treyfortmuller/ee192/README.md

# EE192 Spring 2018: Team 6
Joey Kroeger, Trey Fortmuller, Charlene Shong

### Development Workflow
* The master branch should always be functional.
* For each checkoff, create a branch. When the branch is working and tested, merge it into master.
