treyfortmuller/ee192/notes_and_reference/project_proposal/Proposal Tips.txt

Project Proposal Tips from Varun

Tips from Varun (Discussion):

Essentials
- camera
- chasis/wheels
- motor(s)
- servo 
- e-stop
- battery/power system
- front bumper
Nice to Have
- 2nd camera
- speed sensor
- telemetry/(bluetooth chip)
Sensors
- camera 
- speed (encoder)
- accelerometer
Planning
- which direction? (vision mapper)
- what speed?
