treyfortmuller/ee192/datasheets/optical_encoder_tcrt1000/EasyPulseCircuit.png

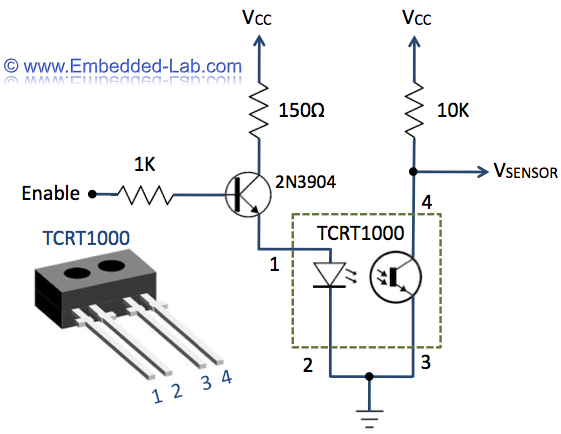
datasheets/optical_encoder_tcrt1000/EasyPulseCircuit.png
