treyfortmuller/ee192/hw2/CarSim2018/2018/successful_runs/1_2.png

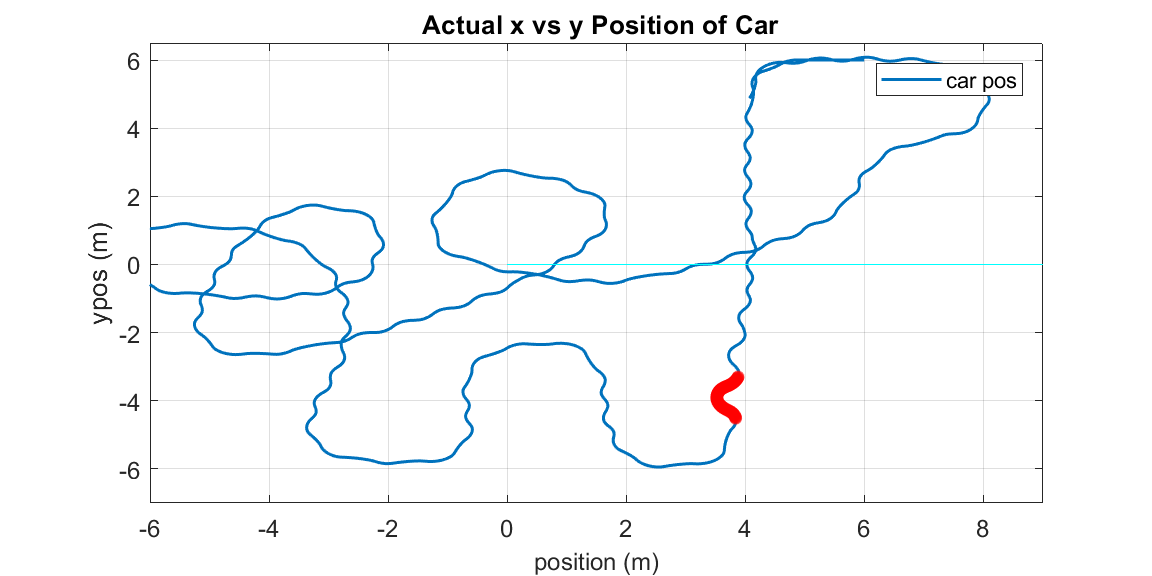
hw2/CarSim2018/2018/successful_runs/1_2.png
