treyfortmuller/ee192/hw2/CarSim2018/2018/successful_runs/2_1.png

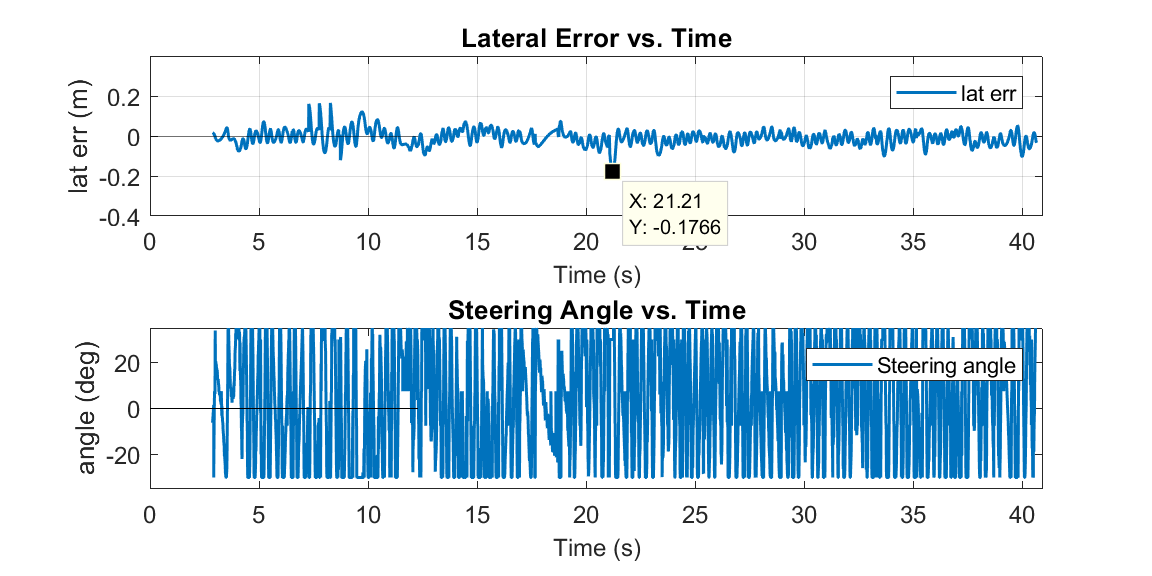
hw2/CarSim2018/2018/successful_runs/2_1.png
