treyfortmuller/ee192/hw2/CarSim2018/2018/successful_runs/2_12.png

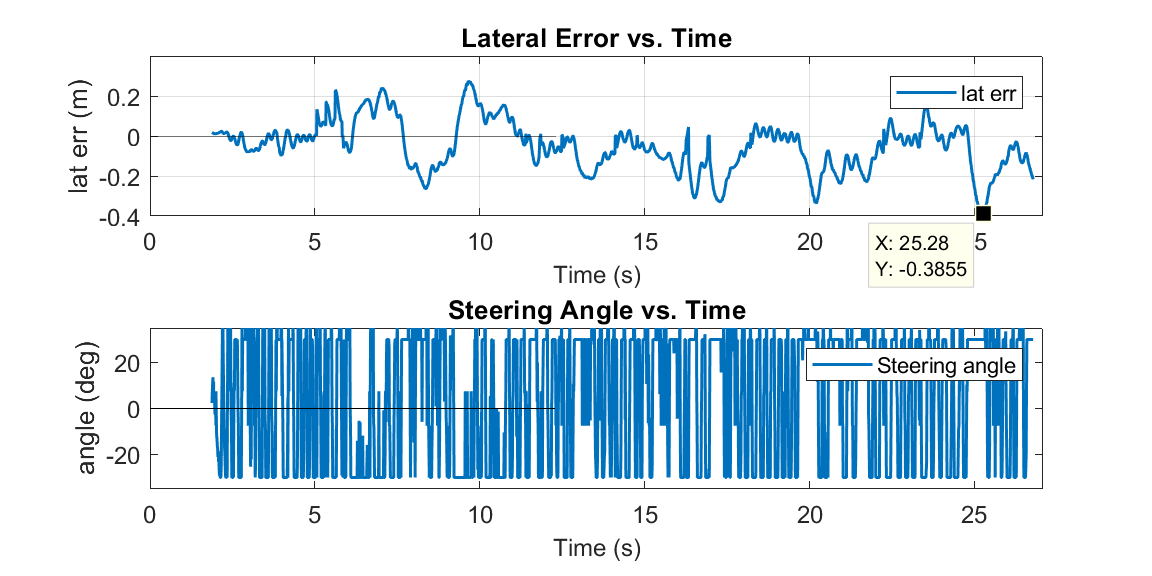
hw2/CarSim2018/2018/successful_runs/2_12.png
