treyfortmuller/ee192/hw2/CarSim2018/2018/successful_runs/4_2.png

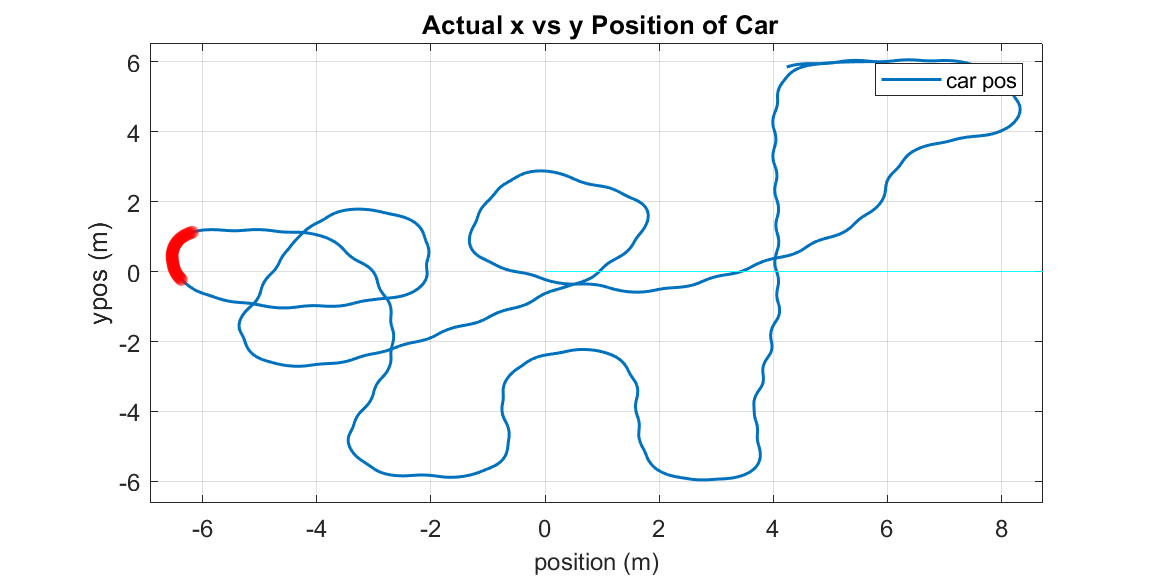
hw2/CarSim2018/2018/successful_runs/4_2.png
