treyfortmuller/ee192/motor_drive_pcb/PCBv1.PNG

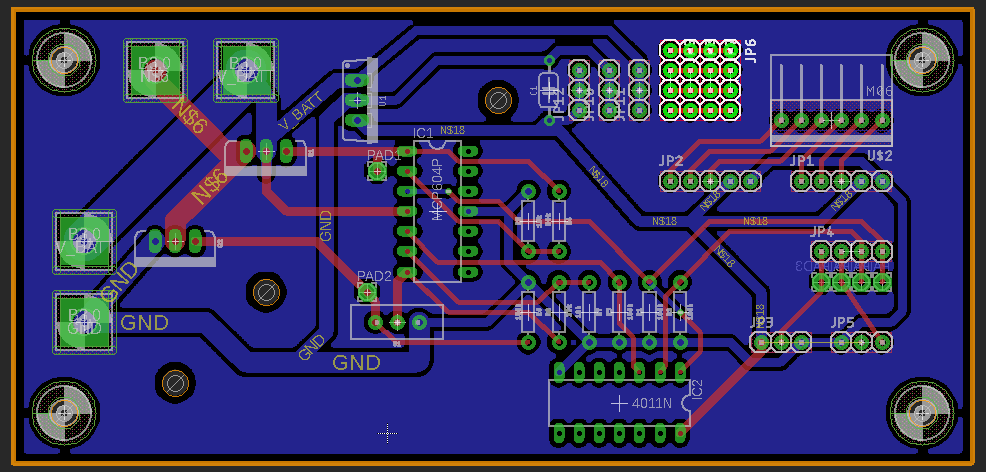
motor_drive_pcb/PCBv1.PNG
