treyfortmuller/ee192/notes_and_reference/project_proposal/motor_circuit.png

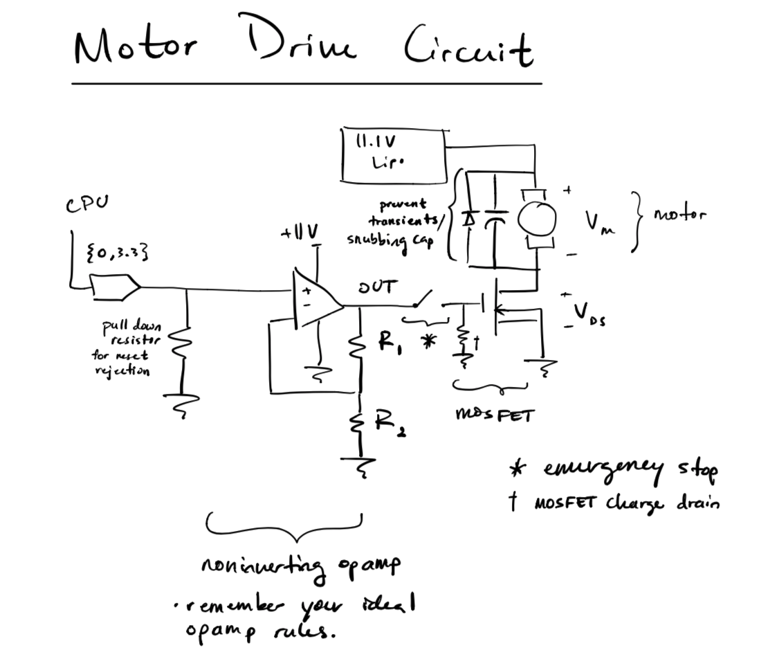
notes_and_reference/project_proposal/motor_circuit.png
