treyfortmuller/ee192/notes_and_reference/sakura_d4_chassis_CAD/SakuraD4Chassis.step

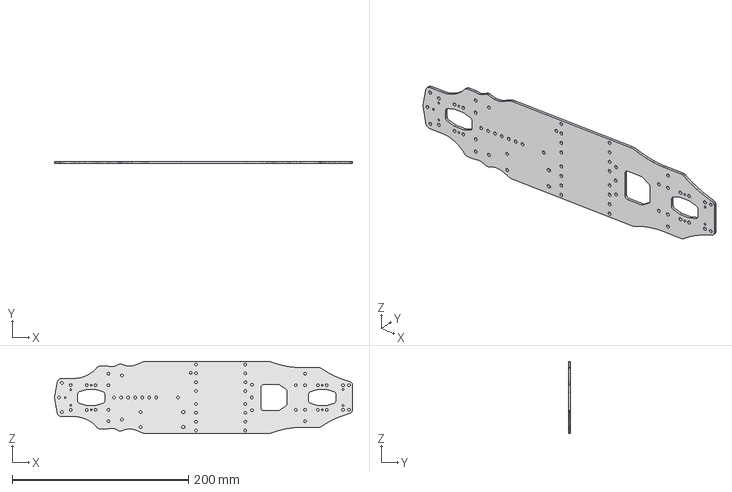
[picture p31: CAD file, 2018-02-09]
notes_and_reference/sakura_d4_chassis_CAD/SakuraD4Chassis.step
338.1 x 2.50 x 82.0 mm
