treyfortmuller/ee192/(list of files, cad)

Other CAD files:
notes_and_reference/sakura_d4_chassis_CAD/SakuraD4Chassis.dwg
notes_and_reference/sakura_d4_chassis_CAD/SakuraD4Chassis.dxf
