treyfortmuller/ee192/motor_drive_pcb/k64_breakout.brd

## EAGLE design motor_drive_pcb/k64_breakout.brd (2018-04-05)

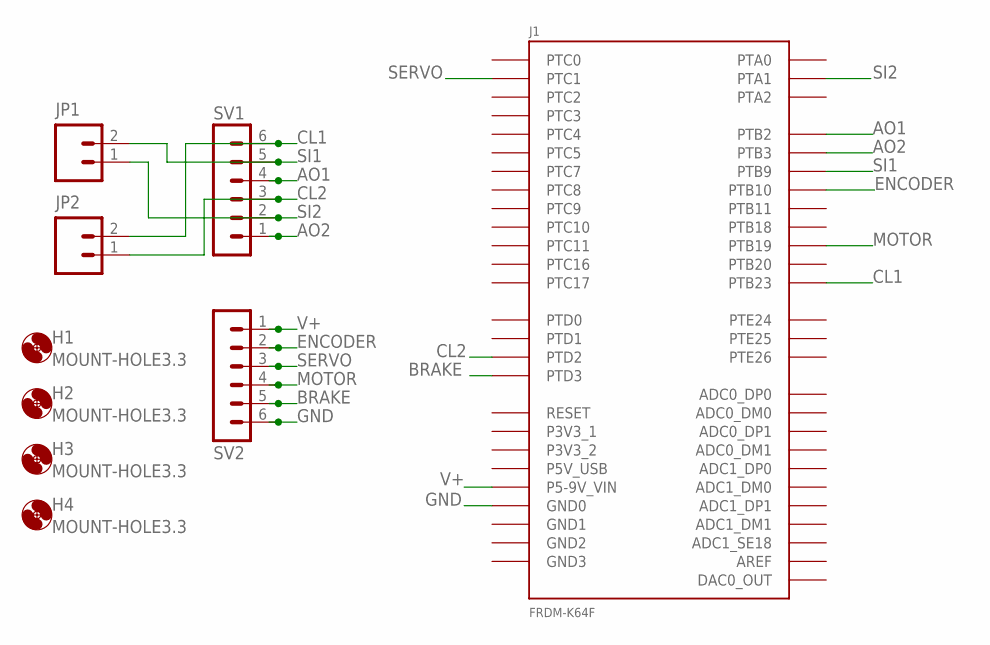
[picture p36: schematic k64_breakout.sch]

Parts:
H1, H2, H3, H4: MOUNT-HOLE3.3; 3,3
J1: FRDM-K64F
JP1, JP2: M02PTH; 1X02
SV1, SV2: MA06-1

Connections:
AO1: J1.J4-2 (PTB2), SV1.4
AO2: J1.J4-4 (PTB3), SV1.1
BRAKE: J1.J2-10 (PTD3), SV2.5
CL1: J1.J1-10 (PTB23), JP2.2, SV1.6
CL2: J1.J2-8 (PTD2), JP2.1, SV1.3
ENCODER: J1.J4-6 (PTB10), SV2.2
GND: J1.J2-3 (GND0), SV2.6
MOTOR: J1.J1-3 (PTB19), SV2.4
SERVO: J1.J1-5 (PTC1), SV2.3
SI1: J1.J1-6 (PTB9), JP1.2, SV1.5
SI2: J1.J1-8 (PTA1), JP1.1, SV1.2
V+: J1.J3-16 (P5-9V_VIN), SV2.1

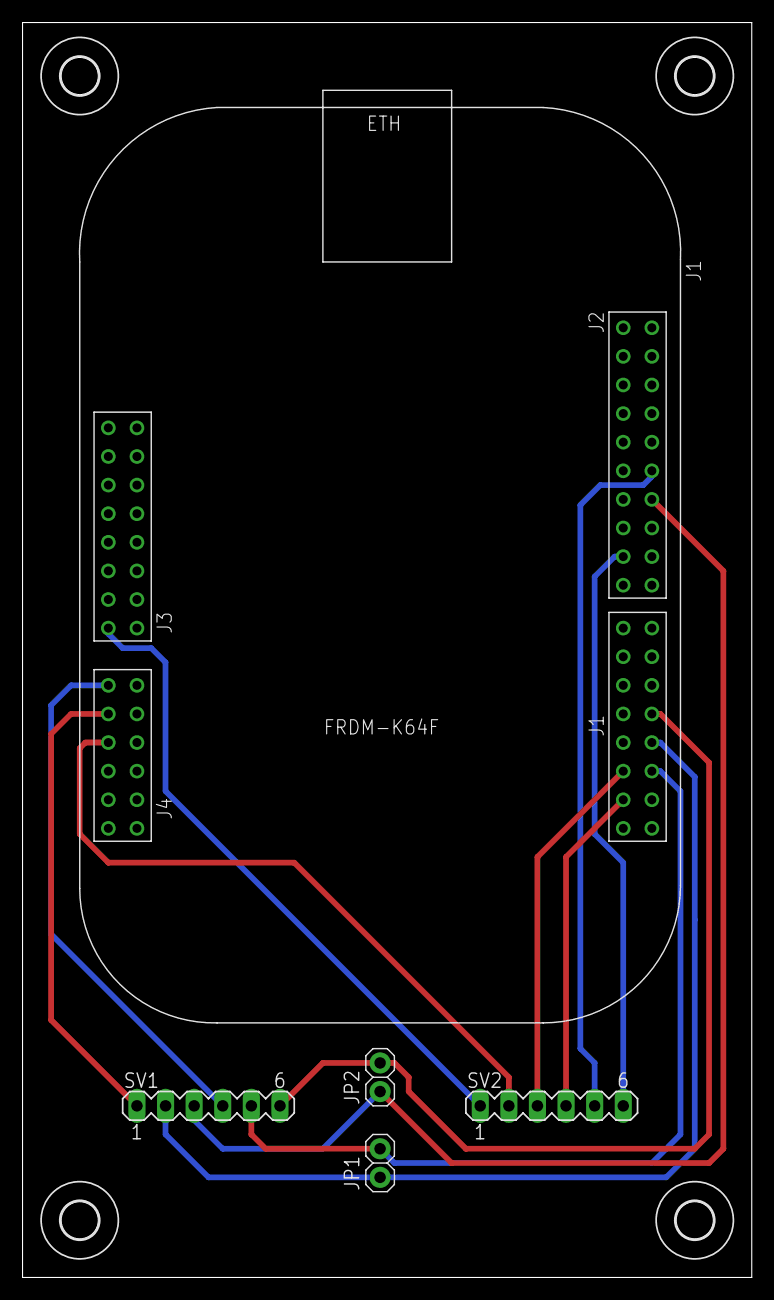
[picture p37: board k64_breakout.brd from above]

Board: 2 copper layers, 64.8 x 111.4 mm, 9 parts (0 on the bottom side), 12 nets.
