treyfortmuller/ee192/motor_drive_pcb/PCB_v1.brd

## EAGLE design motor_drive_pcb/PCB_v1.brd (2018-04-05, an earlier design)

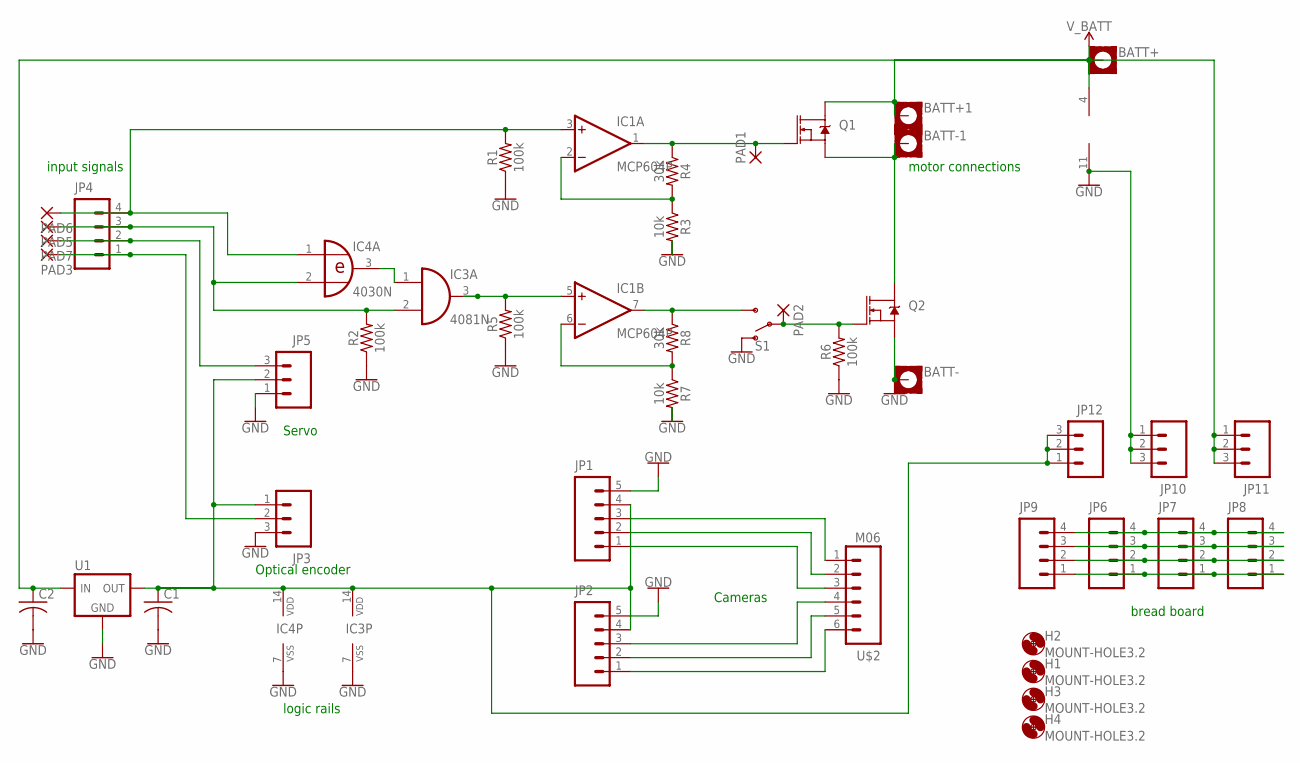
[picture p38: schematic PCB_v1.sch]

Parts:
BATT+, BATT+1: MOUNT-PAD-SQUARE3.0; 3,0-PAD-SQUARE
BATT-, BATT-1: MOUNT-PAD-SQUARE3.0; 3,0-PAD-SQUARE
C1, C2: C-075PTH; C075
H1, H2, H3, H4: MOUNT-HOLE3.2; 3,2
IC1: MCP604P; DIL14
IC3: 4081N; DIL14
IC4: 4030N; DIL14
JP1, JP2: M05PTH; 1X05
JP3, JP5, JP10, JP11, JP12: M03PTH; 1X03
JP4, JP6, JP7, JP8, JP9: M04PTH; 1X04
PAD1, PAD2, PAD3, PAD5, PAD6, PAD7: 2,15/1,0
Q1, Q2: MOSFET-NCH-FQP30N06L; TO220V
R1, R2, R5, R6: 100k; AXIAL-0.3
R3, R7: 10k; AXIAL-0.3
R4, R8: 30k; AXIAL-0.3
S1: SWITCH-SPDT-PTH-11.6X4.0MM-KIT; SWITCH_SPDT_PTH_11.6X4.0MM_KIT
U1: 78XX-TO220V; TO220BV
U$2: M06; 1X06-MTA

Connections:
GND: BATT-.B3,0, C1.2 (-), C2.2 (-), IC1.11 (V-), IC3.7 (VSS), IC4.7 (VSS), JP1.5, JP2.5, JP3.3, JP5.1, JP10.1, JP10.2, JP10.3, Q2.3 (S), R1.P$1 (1), R2.P$1 (1), R3.P$2 (2), R5.P$1 (1), R6.P$1 (1), R7.P$2 (2), S1.1 (O), U1.2 (GND)
unnamed: IC1.2 (-IN), R3.P$1 (1), R4.P$2 (2)
unnamed: IC1.1 (OUT), PAD1.1, Q1.1 (G), R4.P$1 (1)
unnamed: IC1.6 (-IN), R7.P$1 (1), R8.P$2 (2)
unnamed: PAD2.1, Q2.1 (G), R6.P$2 (2), S1.2
unnamed: BATT-1.B3,0, Q1.3 (S), Q2.2 (D)
unnamed: IC1.7 (OUT), R8.P$1 (1), S1.3 (S)
unnamed: IC3.1 (I0), IC4.3 (O)
unnamed: JP2.1, U$2.6
unnamed: JP2.2, U$2.5
unnamed: JP2.3, U$2.4
unnamed: JP1.1, U$2.3
unnamed: JP1.2, U$2.2
unnamed: JP1.3, U$2.1
unnamed: JP4.2, JP5.3, PAD7.1
unnamed: IC1.3 (+IN), IC4.1 (I0), JP4.4, PAD6.1, R1.P$2 (2)
unnamed: IC3.2 (I1), IC4.2 (I1), JP4.3, PAD5.1, R2.P$2 (2)
unnamed: C1.1 (+), IC3.14 (VDD), IC4.14 (VDD), JP1.4, JP2.4, JP3.1, JP5.2, JP12.1, JP12.2, JP12.3, U1.3 (VOUT)
unnamed: JP3.2, JP4.1, PAD3.1
unnamed: IC1.5 (+IN), IC3.3 (O), R5.P$2 (2)
unnamed: JP6.4, JP7.4, JP8.4, JP9.4
unnamed: JP6.3, JP7.3, JP8.3, JP9.3
unnamed: JP6.2, JP7.2, JP8.2, JP9.2
unnamed: JP6.1, JP7.1, JP8.1, JP9.1
V_BATT: BATT+.B3,0, BATT+1.B3,0, C2.1 (+), IC1.4 (V+), JP11.1, JP11.2, JP11.3, Q1.2 (D), U1.1 (VIN)

Notes on the sheet:
Optical encoder
Servo
Cameras
input signals
logic rails
motor connections
bread board

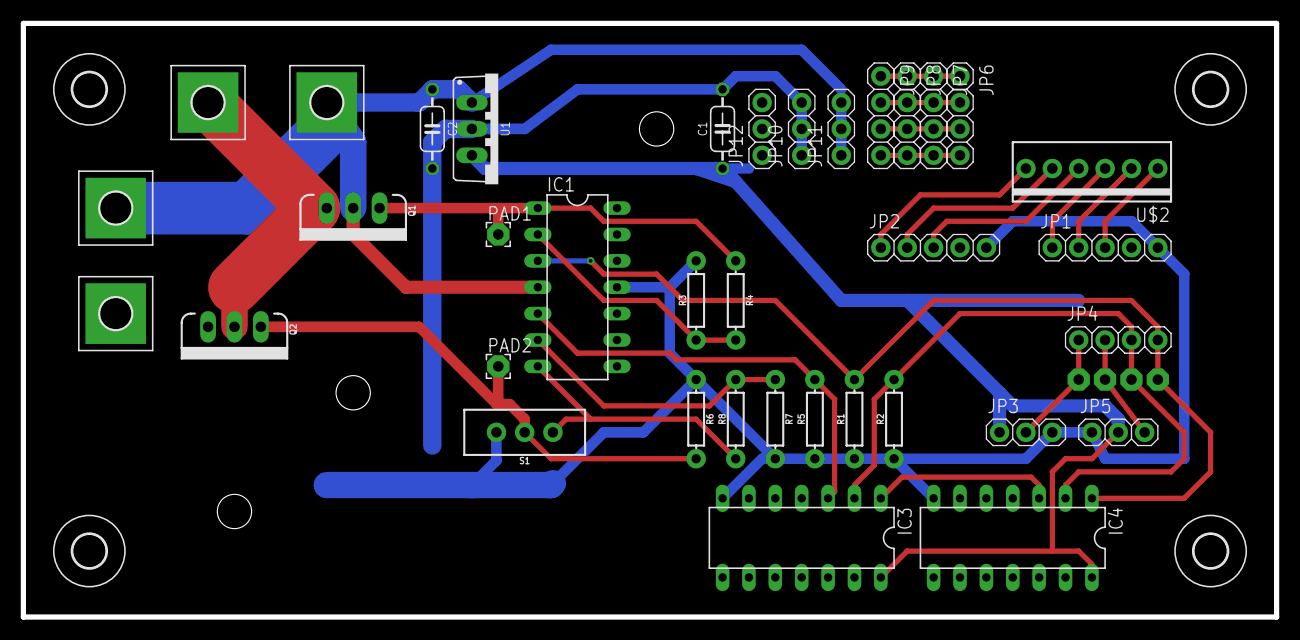
[picture p39: board PCB_v1.brd from above]

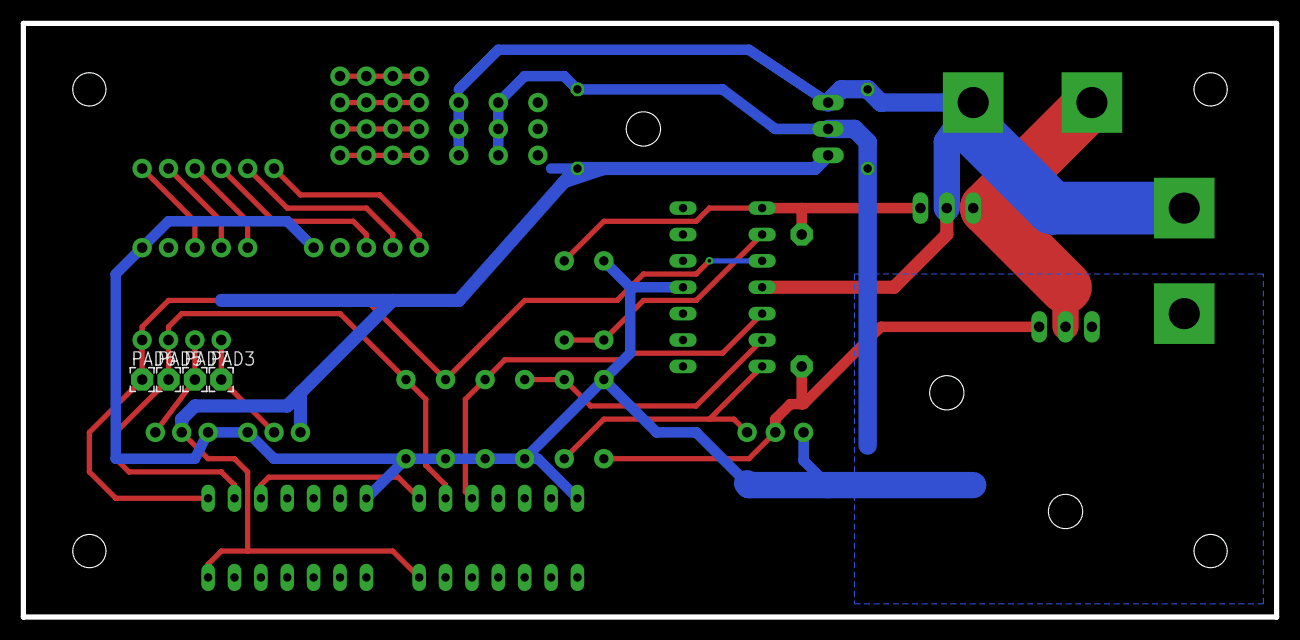
[picture p40: board PCB_v1.brd from below]

Board: 2 copper layers, 120.7 x 57.2 mm, 44 parts (4 on the bottom side), 25 nets.
