treyfortmuller/ee192/encoder_pcb/encoder.brd

## EAGLE design encoder_pcb/encoder.brd (2018-04-05)

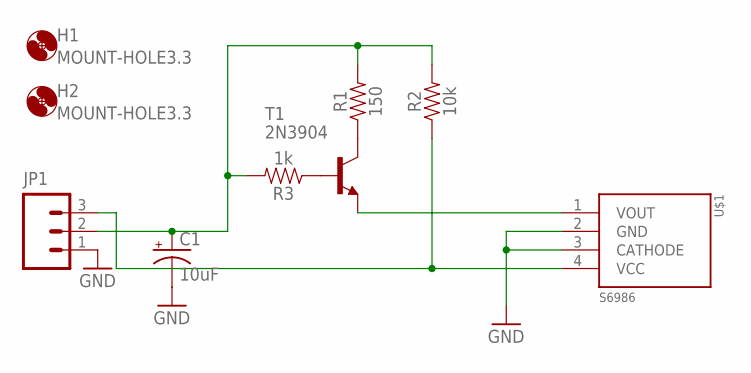
[picture p41: schematic encoder.sch]

Parts:
C1: 10uF; CPOL-RADIAL-2.5MM-5MM-KIT
H1, H2: MOUNT-HOLE3.3; 3,3
JP1: M03PTH; 1X03
R1: 150; AXIAL-0.3
R2: 10k; AXIAL-0.3
R3: 1k; AXIAL-0.3
T1: 2N3904; TO92
U$1: S6986

Connections:
GND: C1.2 (-), JP1.1, U$1.2 (GND), U$1.3 (CATHODE)
unnamed: C1.1 (+), JP1.2, R1.P$2 (2), R2.P$2 (2), R3.P$2 (2)
unnamed: JP1.3, R2.P$1 (1), U$1.4 (VCC)
unnamed: R1.P$1 (1), T1.1 (C)
unnamed: R3.P$1 (1), T1.2 (B)
unnamed: T1.3 (E), U$1.1 (VOUT)

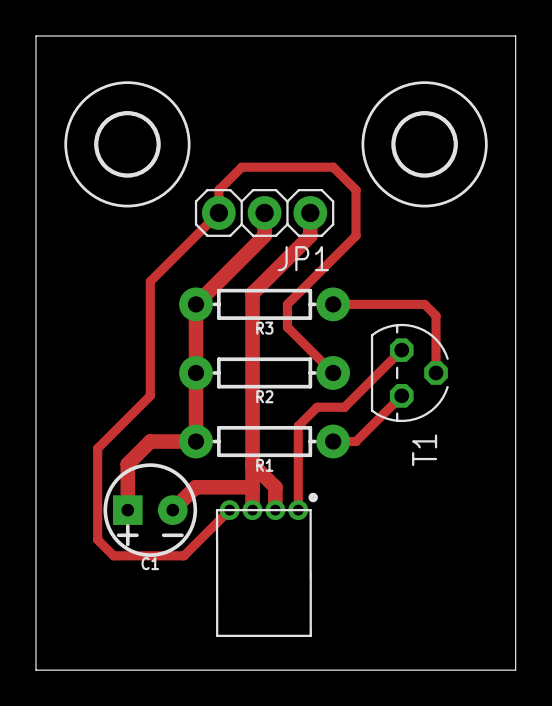
[picture p42: board encoder_pcb/encoder.brd from above]

Board: 2 copper layers, 26.6 x 35.2 mm, 9 parts (0 on the bottom side), 6 nets.
