treyfortmuller/ee192/motor_encoder_pcb/encoder.brd

## EAGLE design motor_encoder_pcb/encoder.brd (2018-04-07)

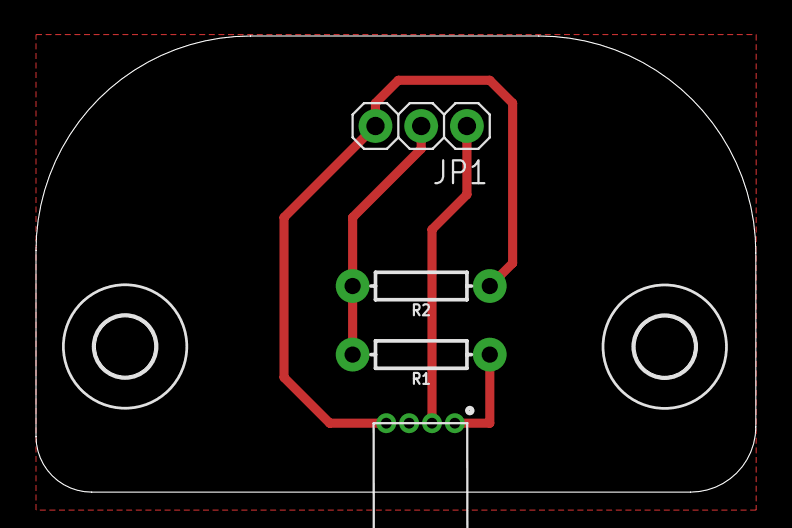
[picture p43: board motor_encoder_pcb/encoder.brd from above]

Board: 2 copper layers, 40.0 x 25.3 mm, 6 parts (0 on the bottom side), 4 nets.

Parts:
H1, H2: MOUNT-HOLE3.3; 3,3
JP1: 1X03
R1: 150; AXIAL-0.3
R2: 10k; AXIAL-0.3
U$1: S6986

Connections:
GND: JP1.1, U$1.2, U$1.3
unnamed: JP1.2, R1.P$2, R2.P$2
unnamed: JP1.3, R2.P$1, U$1.4
unnamed: R1.P$1, U$1.1
