treyfortmuller/ee192/notes_and_reference/project_proposal/motor_drive_basic.sch

## EAGLE design notes_and_reference/project_proposal/motor_drive_basic.sch (2018-01-29)

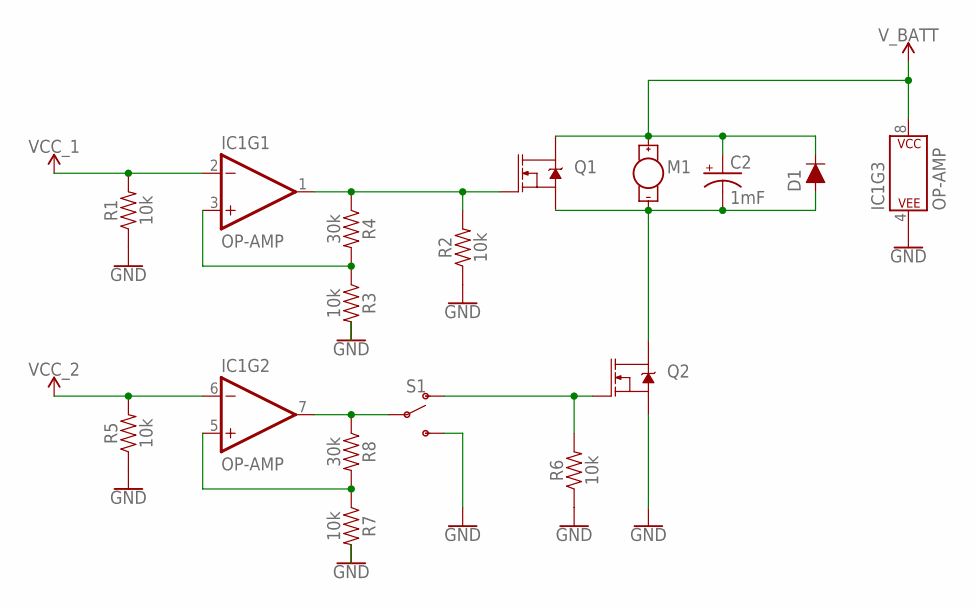
[picture p44: schematic motor_drive_basic.sch]

Parts:
C2: 1mF; CPOL-RADIAL-5MM-10MM
D1: DIODE-1N4148
IC1: OP-AMP; DIP08
M1: MOTOR10MM; VIBE-MOTOR-10MM
Q1, Q2: MOSFET-NCH-FQP30N06L; TO220V
R1, R2, R3, R5, R6, R7: 10k; AXIAL-0.3
R4, R8: 30k; AXIAL-0.3
S1: SWITCH-SPDT-PTH-11.6X4.0MM-KIT; SWITCH_SPDT_PTH_11.6X4.0MM_KIT

Connections:
GND: IC1.4 (P$V-), Q2.3 (S), R1.P$1 (1), R2.P$1 (1), R3.P$2 (2), R5.P$1 (1), R6.P$1 (1), R7.P$2 (2), S1.3 (S)
unnamed: IC1.3 (+IN), R3.P$1 (1), R4.P$2 (2)
unnamed: IC1.1 (OUT), Q1.1 (G), R2.P$2 (2), R4.P$1 (1)
unnamed: IC1.5 (+IN), R7.P$1 (1), R8.P$2 (2)
unnamed: Q2.1 (G), R6.P$2 (2), S1.1 (O)
unnamed: C2.-, D1.A, M1.-, Q1.3 (S), Q2.2 (D)
unnamed: IC1.7 (OUT), R8.P$1 (1), S1.2
VCC_1: IC1.2 (-IN), R1.P$2 (2)
VCC_2: IC1.6 (-IN), R5.P$2 (2)
V_BATT: C2.+, D1.C, IC1.8 (P$V+), M1.+, Q1.2 (D)
