treyfortmuller/ee192/(commit log)

2018-01-26 switched supporting files for checkoff_1 to blink_led skeleton
2018-01-29 motor drive circuit schematic
    [motor_drive_basic.sch]
2018-02-05 research notes
    [SakuraD4Chassis.dwg, SakuraD4Chassis.dxf, SakuraD4Chassis.step, motor_drive_basic.sch]
2018-02-08 added steering servo pwm output logic
2018-02-21 eagle schematic
    [PCB_v1.brd, PCB_v1.sch, motor_drive_basic.brd, motor_drive_basic.sch]
2018-02-21 PCB updates
2018-03-01 updates to PCB
2018-03-01 moved adc demo code into main.c
2018-03-01 tcrt optical encoder datasheet and info
2018-03-02 velocity sensing logic
2018-03-02 updated main/c for velocity sensing
2018-03-07 hw1 files and directory
    [natcar2016_team1.csv]
2018-03-07 reorganization and new working project directory
    [PCB_v1.brd, PCB_v1.sch, motor_drive_basic.brd, motor_drive_basic.sch]
2018-03-07 directory clean up
    [PCB_v1.brd, PCB_v1.sch, motor_drive_basic.brd, motor_drive_basic.sch]
2018-03-08 added mosfet datasheet
2018-03-12 changes to main for second FTM0 channel and pin
2018-03-13 individual frame plotting
2018-03-16 changes to main for servo commands for figure 8
2018-03-20 working camera and new pwm pin
2018-03-21 second adc pin PTB10 initialization code added
2018-03-23 both adc pins working but linear encoder not reading
2018-03-23 complete hw2 files
    [car_data.csv, car_data_all.csv, car_data_pdandsteer.csv, car_data_pdcontrol.csv, car_data_pdcontrol2.csv, car_data_ponly.csv]
2018-04-05 encoder PCB started
    [encoder.brd, encoder.sch]
2018-04-05 added the encoder PCB desing files
    [encoder.brd, encoder.sch]
2018-04-05 updated pcb and encoder schematics and boards
    [PCB_v1.brd, PCB_v1.sch, PCB_v2.brd, PCB_v2.sch, k64_breakout.brd, k64_breakout.sch, motor_drive_basic.brd]
2018-04-05 encoder pcb changes
    [encoder.brd]
2018-04-05 pcb outputs
    [copper_top.gbr, drills.xln, profile.gbr]
2018-04-06 some small potential fixes
    [main.c]
2018-04-06 not working telemetry code
    [main.c]
2018-04-07 correctly restructured but nonfunctional code w/ telemetry
    [main.c]
2018-04-07 new encoder PCB output
    [encoder.brd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]
2018-04-08 fixed encoder board to have proper spacing of encoder mounting holes for othermill
2018-04-09 sort of working velocity command based on servo pwm
2018-04-22 working adjusted checkoff7 code for lower freq for servos
2018-04-23 working code with PIT timing and velocity control
2018-04-23 barely working code with new servo and new motor
2018-04-23 working code for old motor and servo
